AdrienWaeles/french-robotics-cup-2024/Loïc's Reports/Session 12.md

# March 12, 2024
## Main robot
Two session ago, I modeled and printed the system which will hold the plants against the robot's frame. when I tried to mount them on the robot, I realized that the system was a little bit too long. I had to cut it and reassemble it. The difficulty was to cut the guide rail because it is made out of hardened steel so it cannot be cutted with a regular steel saw. Finally I found out that a [Dremel®]('https://www.dremel.com/fr/fr/p/dremel-8260-f0138260ja') with the right blade was able to cut through it whithout too much difficulties.

<div align="center">
    

    Cutted rail guide
</div>

## Ladybug robot
### Components
Last session, I chose the components for the ladybug robot. Before starting to model the ladybug itself, I modeled on SolidWorks the components that will be used in the robot. I modeled the DC motor, the servo motors and the DWM1001 module. I found the other components on the internet because they are standard. Here are the components I modeled myself on SolidWorks:

<div align="center">
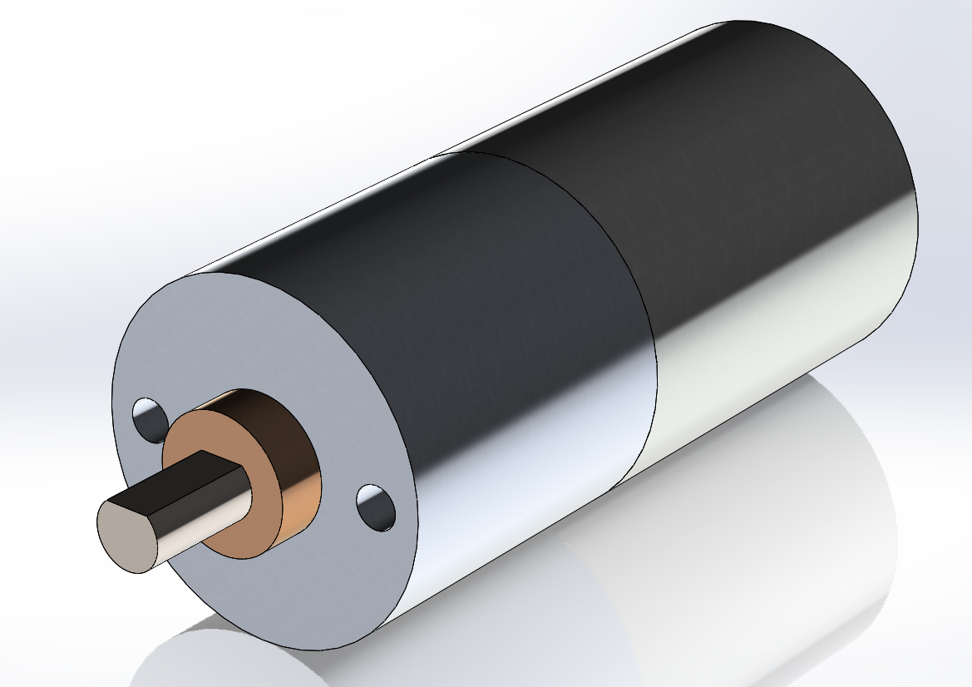
[picture p21: Loïc's Reports/src/session_12/moteur dc.png]
DC motor
    

    DC motor
</div>
<div align="center">
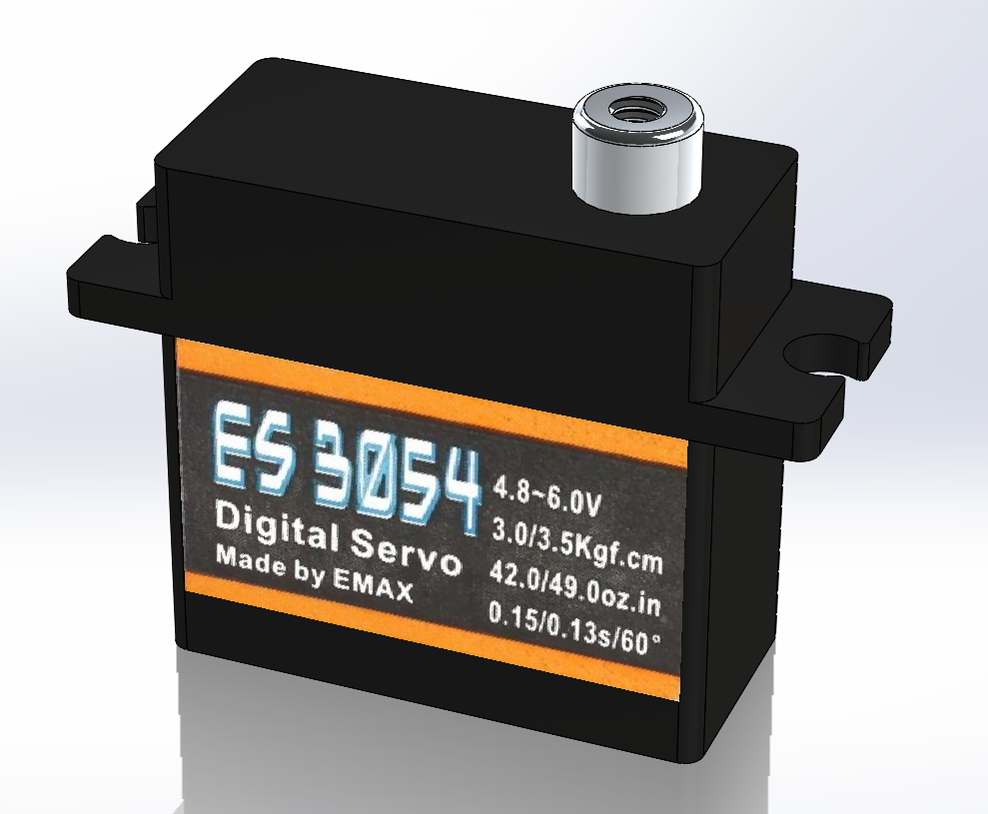
[picture p22: Loïc's Reports/src/session_12/servo 1.png]
Servo motor
    

    Servo motor (for the direction)
</div>
<div align="center">
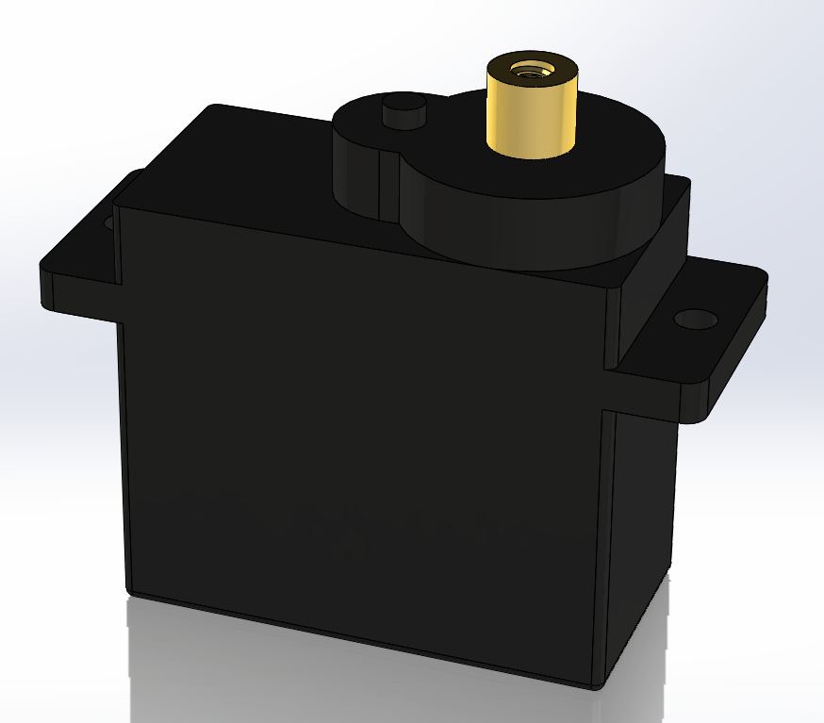
[picture p23: Loïc's Reports/src/session_12/servo 2.png]
Servo motor
    

    Servo motor (for the actuator), a bit smaller than the previous one
</div>
<div align="center">
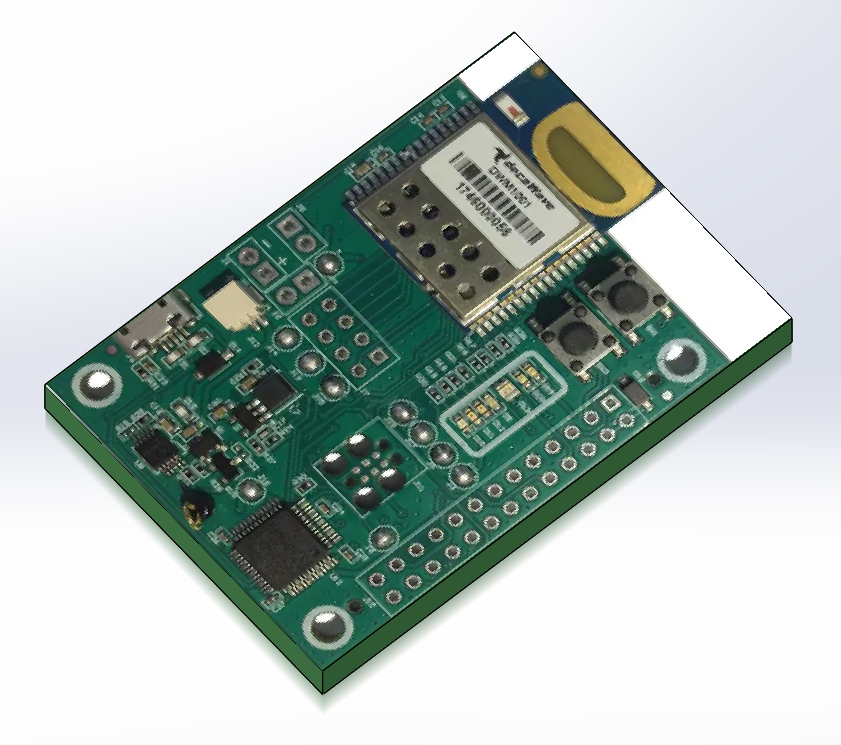
[picture p24: Loïc's Reports/src/session_12/DWM1001.png]
    

    DWM1001 module
</div>

Here are the components I found on the internet ([GrabCAD]('https://grabcad.com/library')):
<div align="center">
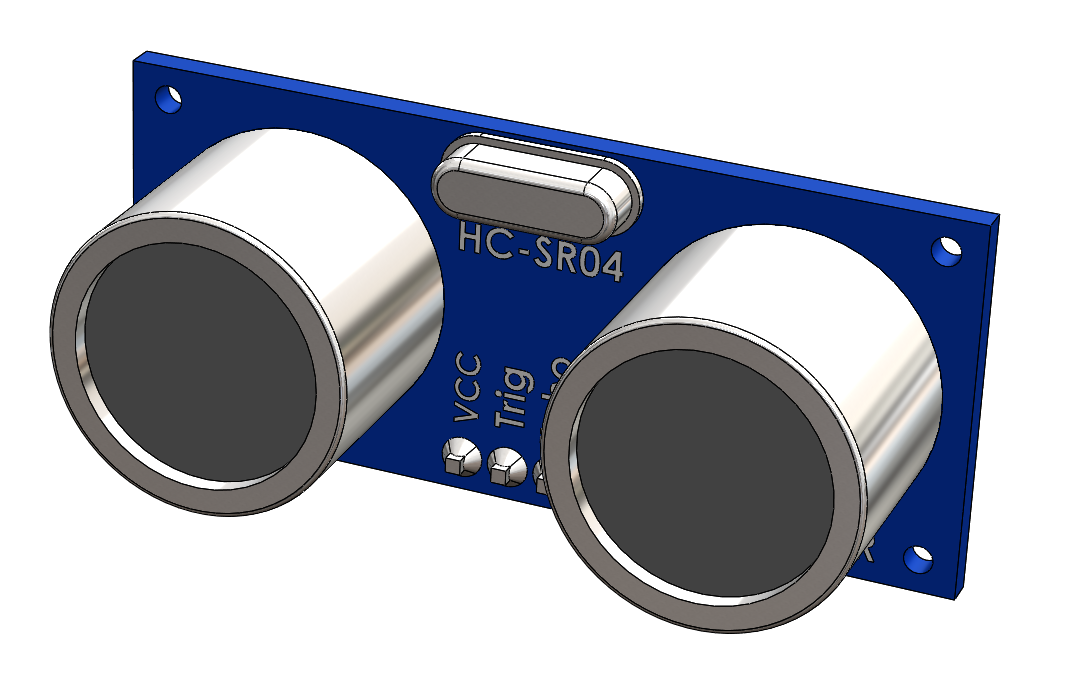
[picture p25: Loïc's Reports/src/session_12/ultrasonic.png]
    

    Ultrasonic sensor
</div>
<div align="center">
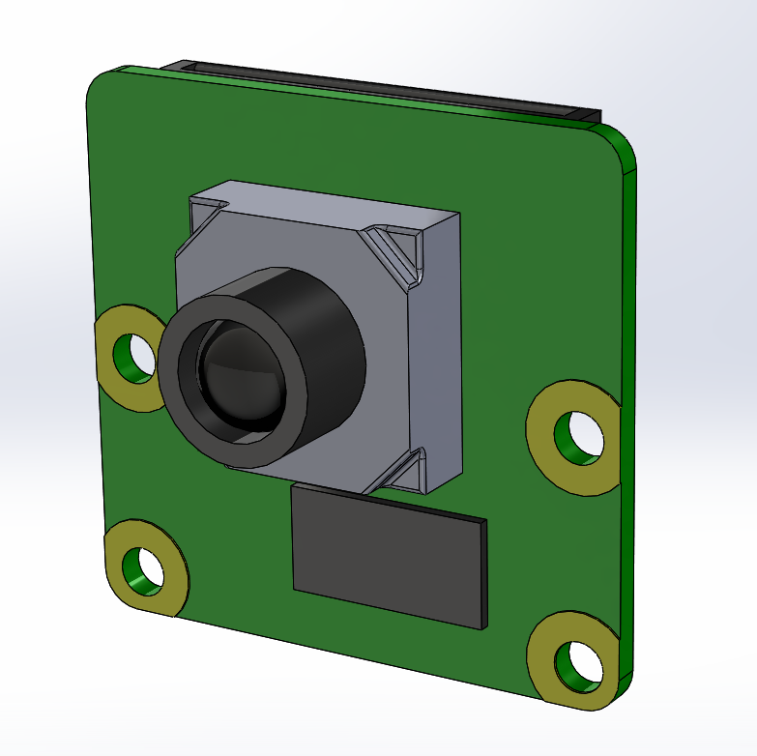
[picture p26: Loïc's Reports/src/session_12/camera.png]
    

    Raspberry Pi camera
</div>
<div align="center">
    Servo motor

    18650 battery in a holder
</div>
<div align="center">
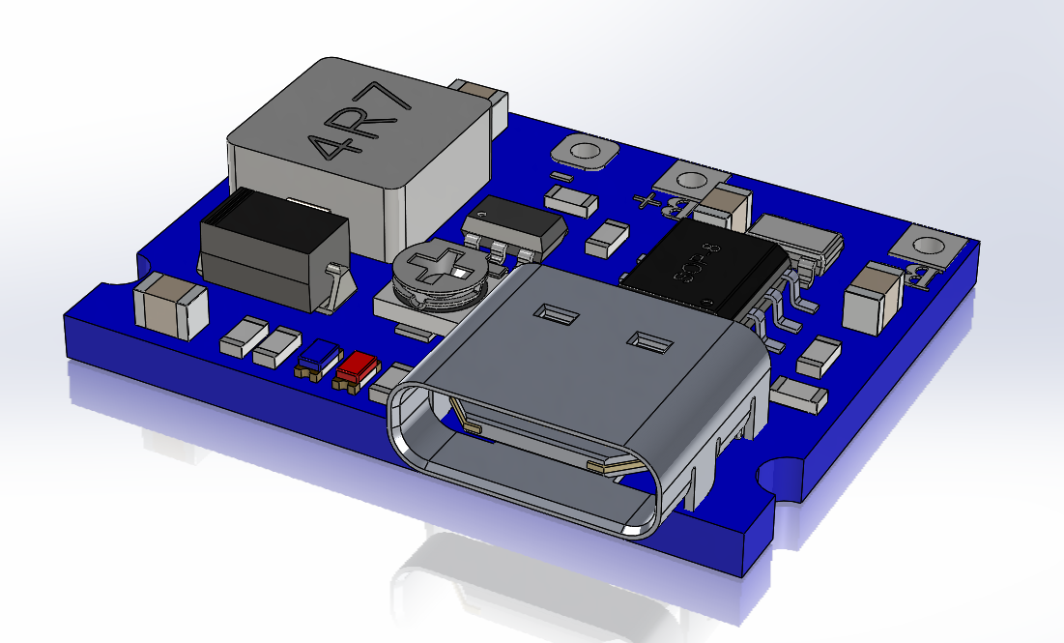
[picture p27: Loïc's Reports/src/session_12/bms.png]
    

    BMS (Battery Management System) for the 18650 battery and step-up module (3.7V to 5V)
</div>
<div align="center">
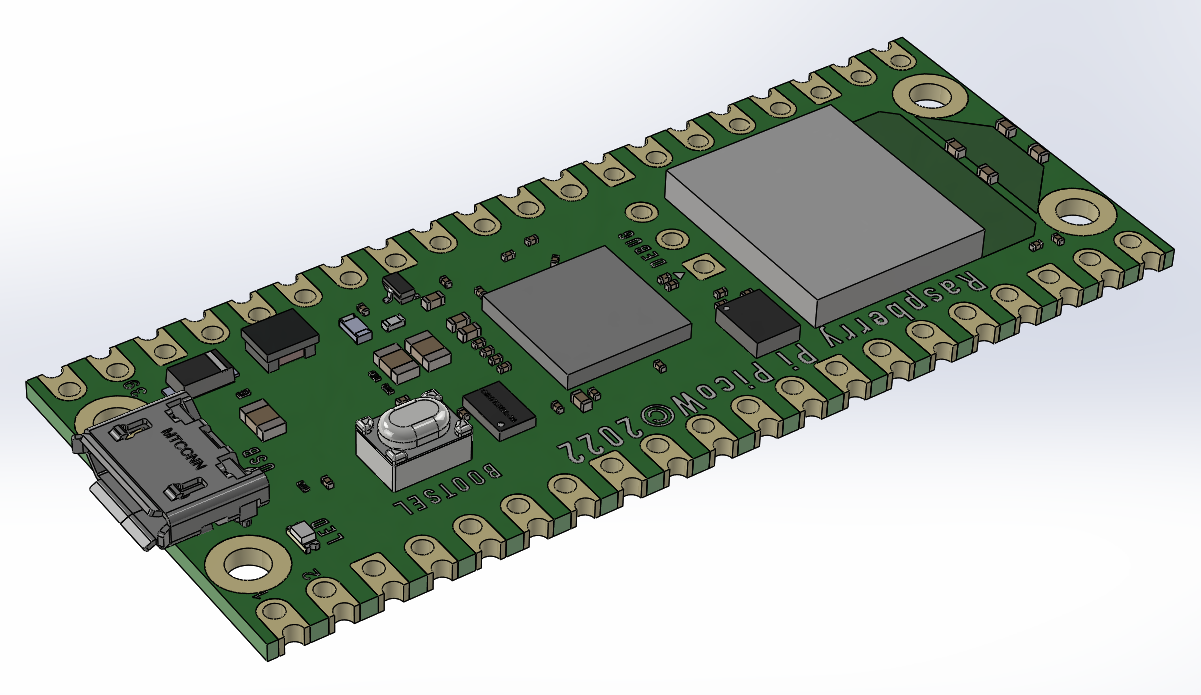
[picture p28: Loïc's Reports/src/session_12/raspberry.png]
    

    Raspberry Pi Zero W
</div>
<div align="center">
    Servo motor

    Emergency stop switch
</div>

### Chassis
For the chassis, I modeled it as compact and simple as possible. I designed it so that the DC motor is inside the chassis, so that its mass serves to stabilize the ladybug. The structure of the chassis is very rigid because of its geometry, when can see some holes on the top which are made to screw the other parts on it. Here is the design I came up with:

<div align="center">
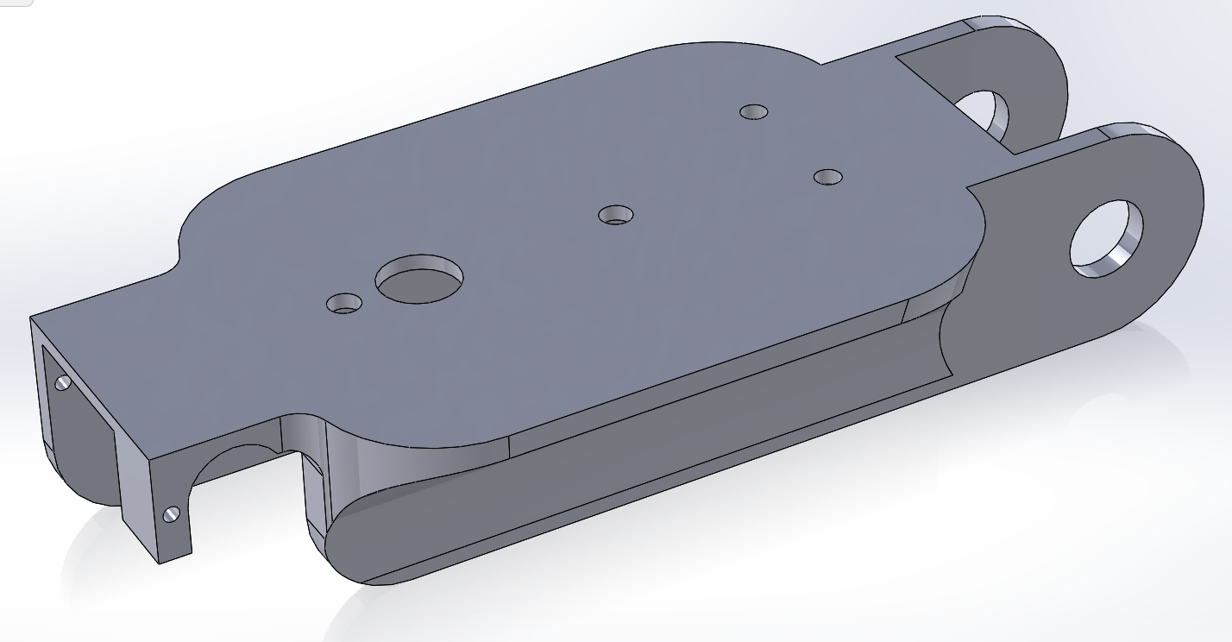
[picture p29: Loïc's Reports/src/session_12/chassis.png]
Chassis
    

    Chassis (Top view)
</div>
<div align="center">
    Chassis

    Chassis (Bottom view)
</div>
<div align="center">
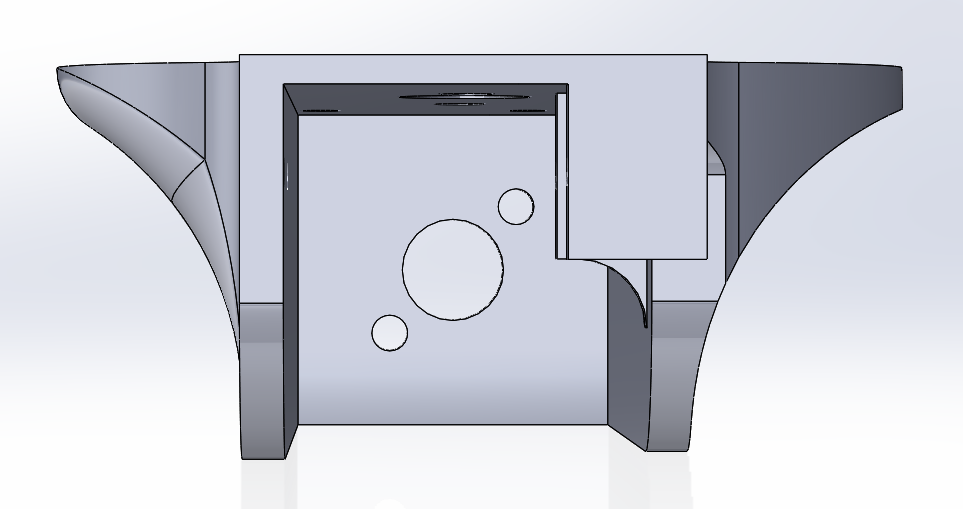
[picture p30: Loïc's Reports/src/session_12/chassis3.png]
Chassis
    

    Chassis (front view)
</div>

Then I added to the chassis the DC motor, the servo motor for the direction and the wheels. A small wheel is mounted on a fork which is attached to the servo motor. In order to transmit the rotational power from the DC motor to the wheels, I designed a small gear system. The gear ratio is 1:1, so the wheels will rotate at the same speed as the DC motor which is already designed at the right speed. The wheels might be a little bit too much apart but I will see this detail later. Here is the chassis with the motors and the wheels:

<div align="center">
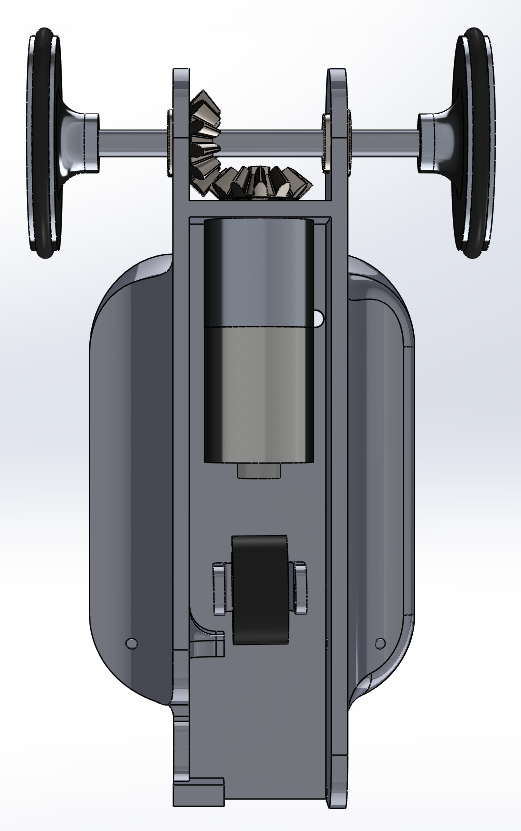
[picture p31: Loïc's Reports/src/session_12/chassis4.png]
Chassis
    

    Chassis with the DC motor, the servo motor and the wheels (Bottom view)
</div>
<div align="center">
    Chassis

    Chassis with the DC motor, the servo motor and the wheels (Top view)
</div>

## Next session
- Continue the ladybug robot
- Adjust some parts of the main robot
