AdrienWaeles/french-robotics-cup-2024/docs/lab-reports/loic/assets/session-11/20240305_111251.jpg

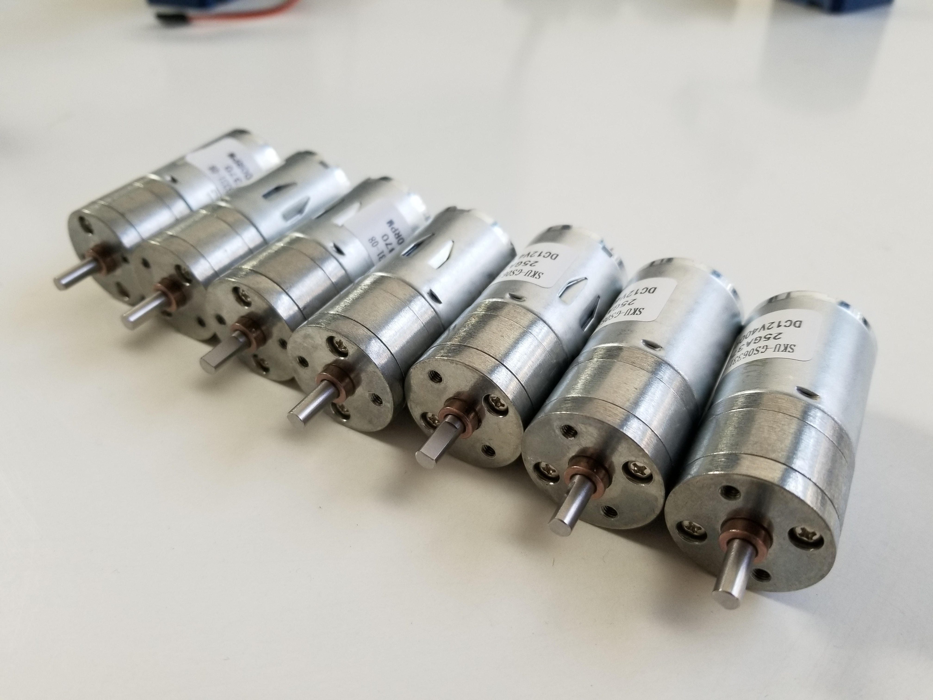
docs/lab-reports/loic/assets/session-11/20240305_111251.jpg
