AdrienWaeles/french-robotics-cup-2024/docs/lab-reports/loic/assets/session-11/emergency switch.png

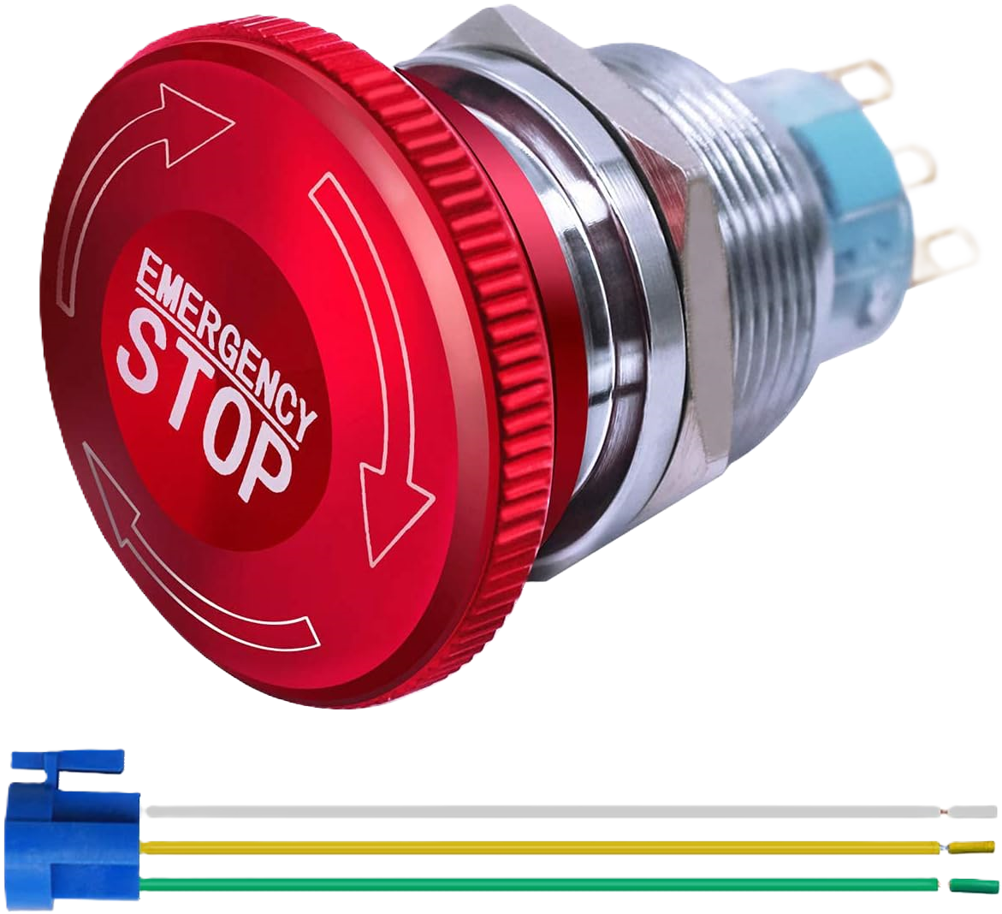
docs/lab-reports/loic/assets/session-11/emergency switch.png
