AdrienWaeles/french-robotics-cup-2024/docs/lab-reports/loic/assets/session-12/chassis2.png

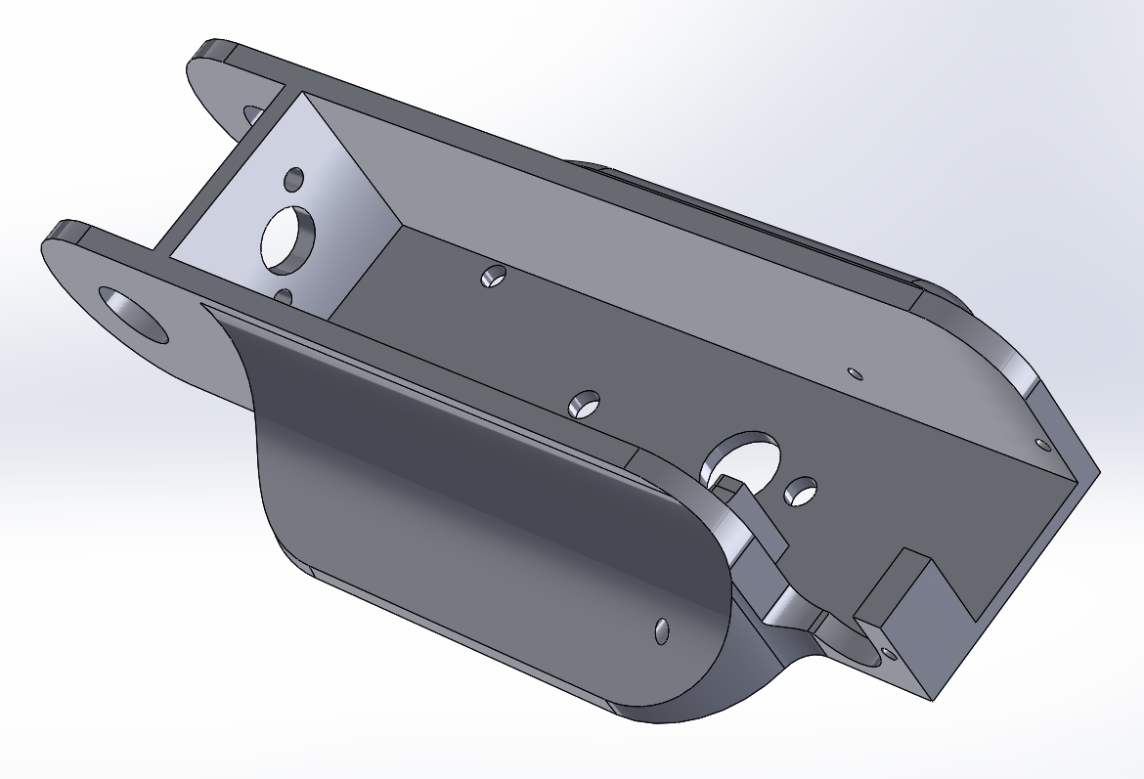
docs/lab-reports/loic/assets/session-12/chassis2.png
