AdrienWaeles/french-robotics-cup-2024/docs/lab-reports/loic/assets/session-13/T shape.png

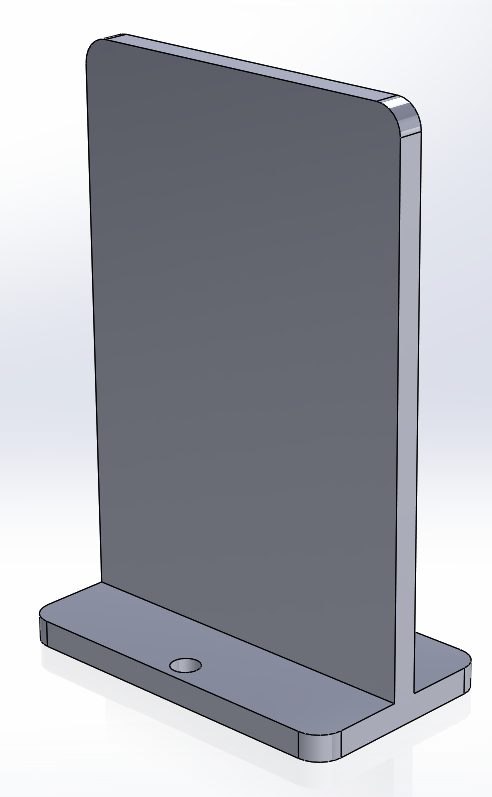
docs/lab-reports/loic/assets/session-13/T shape.png
