AdrienWaeles/french-robotics-cup-2024/docs/lab-reports/loic/assets/session-16/cameras mount.png

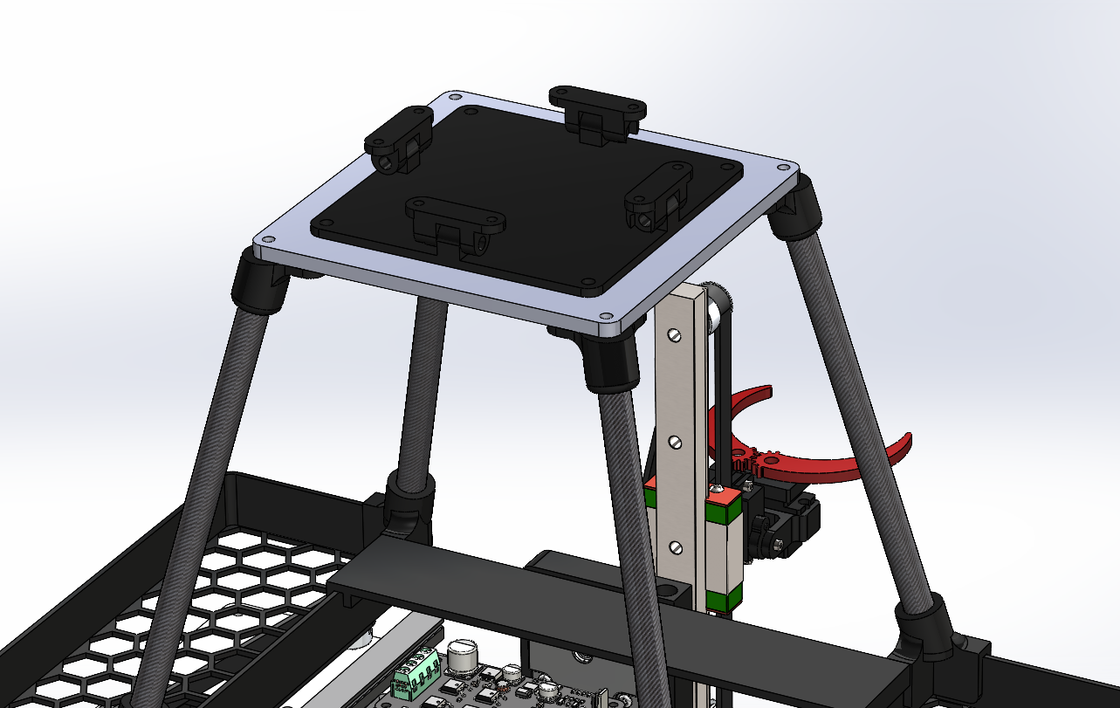
docs/lab-reports/loic/assets/session-16/cameras mount.png
