AdrienWaeles/french-robotics-cup-2024/Loïc's Reports/src/session_12/20240316_220356.jpg

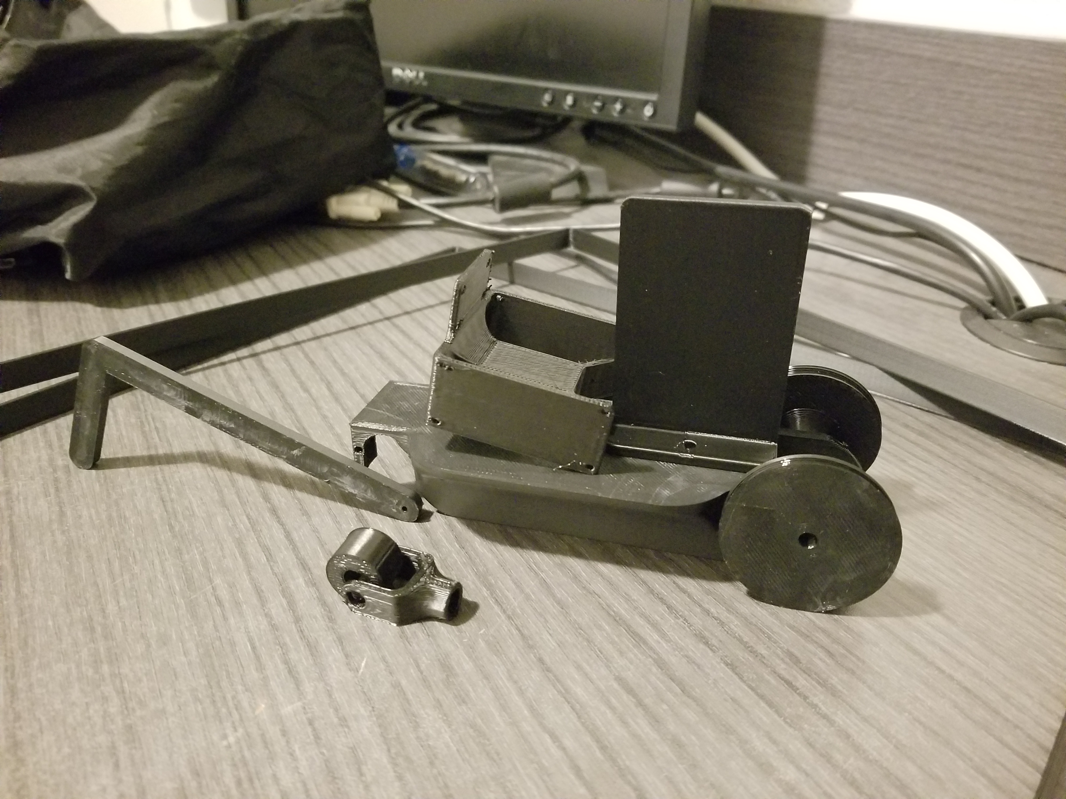
Loïc's Reports/src/session_12/20240316_220356.jpg
