AdrienWaeles/french-robotics-cup-2024/polymartien light.png

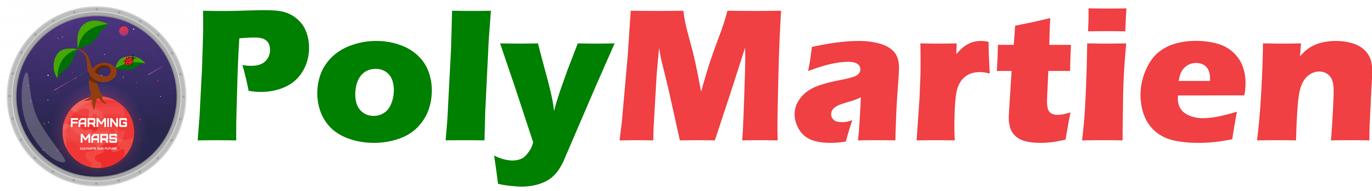
polymartien light.png
