AdrienWaeles/french-robotics-cup-2024/src/plante + pot.png

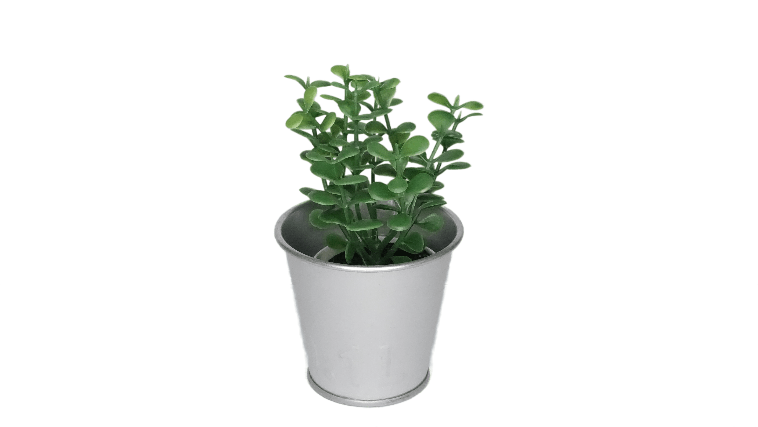
src/plante + pot.png
