AdrienWaeles/french-robotics-cup-2024/hardware/bill-of-materials.md

# Preliminary bill of materials

Cost estimate from the design phase (see the [preliminary design report](../docs/preliminary-design-report.pdf)).
The final budget, €6,191 including the cameras, the swarm robots and travel, is detailed in the
[project retrospective](../docs/project-retrospective.pdf).

| Item | Qty | Cost (€) |
|---|---:|---:|
| Plywood sheet, 5 mm, 300 × 600 mm | 1 | 5 |
| 3D printing (7 h 30, 90 g) |  | 2.7 |
| 3D printing (1 h 30, 20 g) |  | 0.6 |
| Brushless motors | 2 | 62 |
| Emergency stop button | 1 | 8.5 |
| Roller wheels | 2 pairs | 24 |
| Linear guide, 300 × 600 mm | 1 | 32 |
| Belts, 5 m × 6 mm × 2 mm | 3 | 25 |
| DC motors, 24 V, 35 W, 220 rpm | 2 | 234 |
| NEMA 17 stepper motor | 1 | 13 |
| GT2 pulleys | 2 | 2.7 |
| Stepper driver (Arduino) | 1 | 2.2 |
| Cytron DC motor drivers, 5–30 V, 10 A | 2 | 26 |
| Arduino Mega | 1 | 23 |
| NVIDIA Jetson Nano | 1 | 250 |
| V-slot aluminium profiles, 250 × 20 × 20 mm | 4 | 55 |
| Assorted screws |  | 20 |
| Game mat and printed game elements |  | 170 |
| Construction wood |  | 135 |
| Wood delivery |  | 60 |
| **Total** | | **1150.7** |
