AdrienWaeles/french-robotics-cup-2024/Fabrication/coin.STL

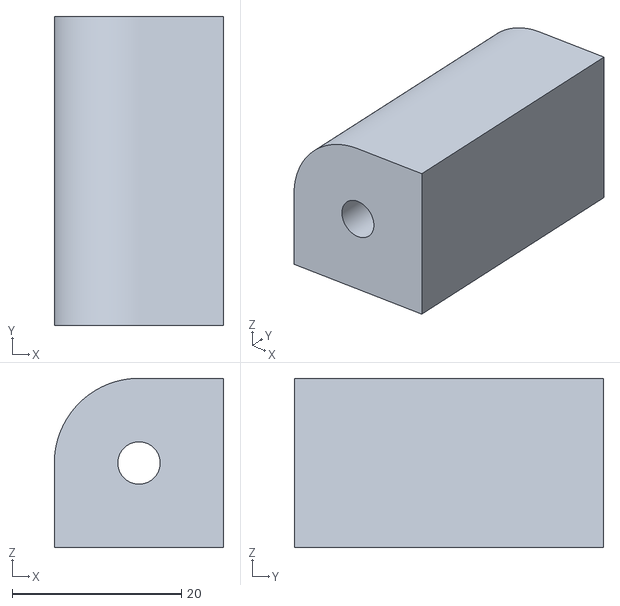
[picture p53: CAD file, 2023-10-07]
Fabrication/coin.STL
20.0 x 36.5 x 20.0
