AdrienWaeles/french-robotics-cup-2024/Fabrication/Impressions 3D/support nema plateau.STL

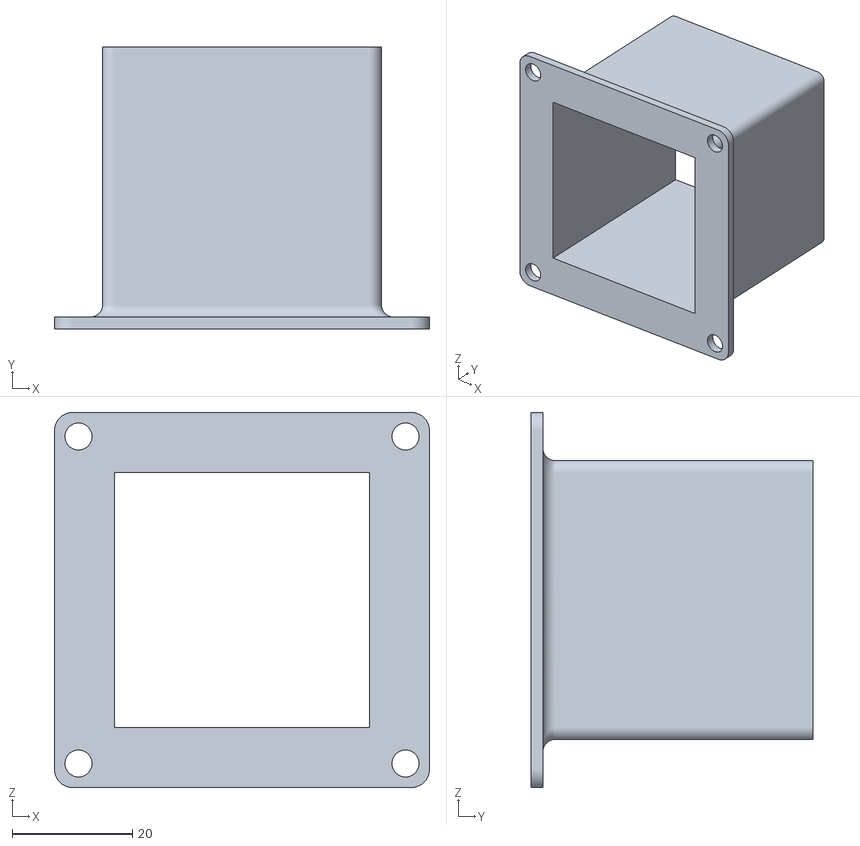
[picture p54: CAD file, 2023-10-07]
Fabrication/Impressions 3D/support nema plateau.STL
62.5 x 47.0 x 62.5
