AdrienWaeles/french-robotics-cup-2024/Loïc's Reports/src/session_03/support pivot.stl

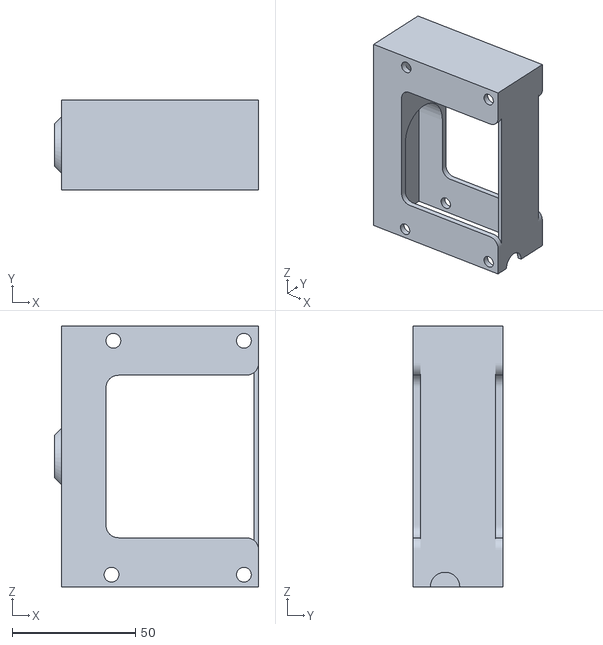
[picture p55: CAD file, 2023-12-09]
Loïc's Reports/src/session_03/support pivot.stl
83.0 x 36.5 x 106.0
