AdrienWaeles/french-robotics-cup-2024/Fabrication/support roulement.STL

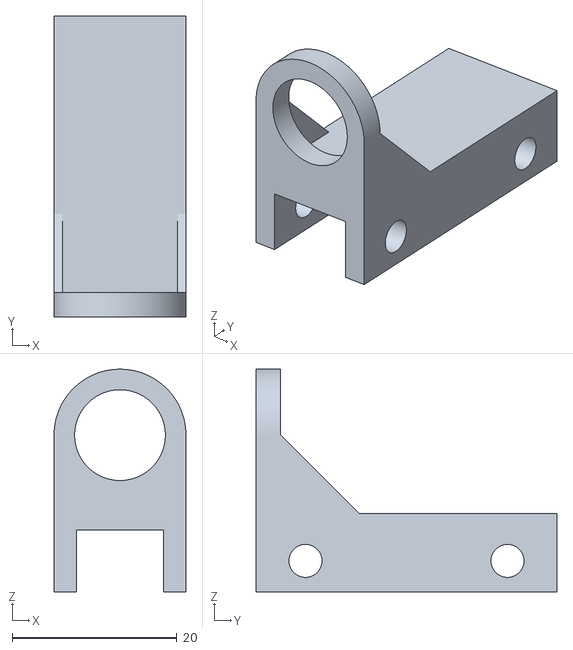
[picture p56: CAD file, 2023-10-07]
Fabrication/support roulement.STL
16.0 x 36.5 x 27.0
