AdrienWaeles/french-robotics-cup-2024/Fabrication/support moteur.STL

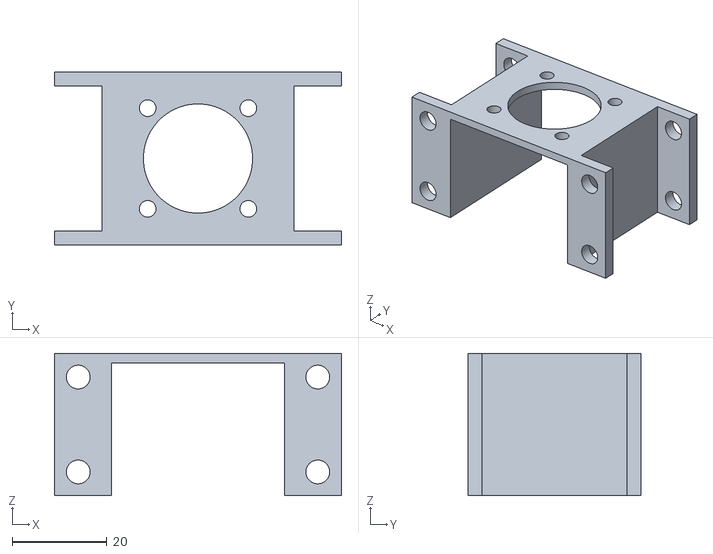
[picture p57: CAD file, 2023-10-07]
Fabrication/support moteur.STL
60.5 x 36.5 x 30.0
