AdrienWaeles/french-robotics-cup-2024/Fabrication/commande profilé alu.jpg

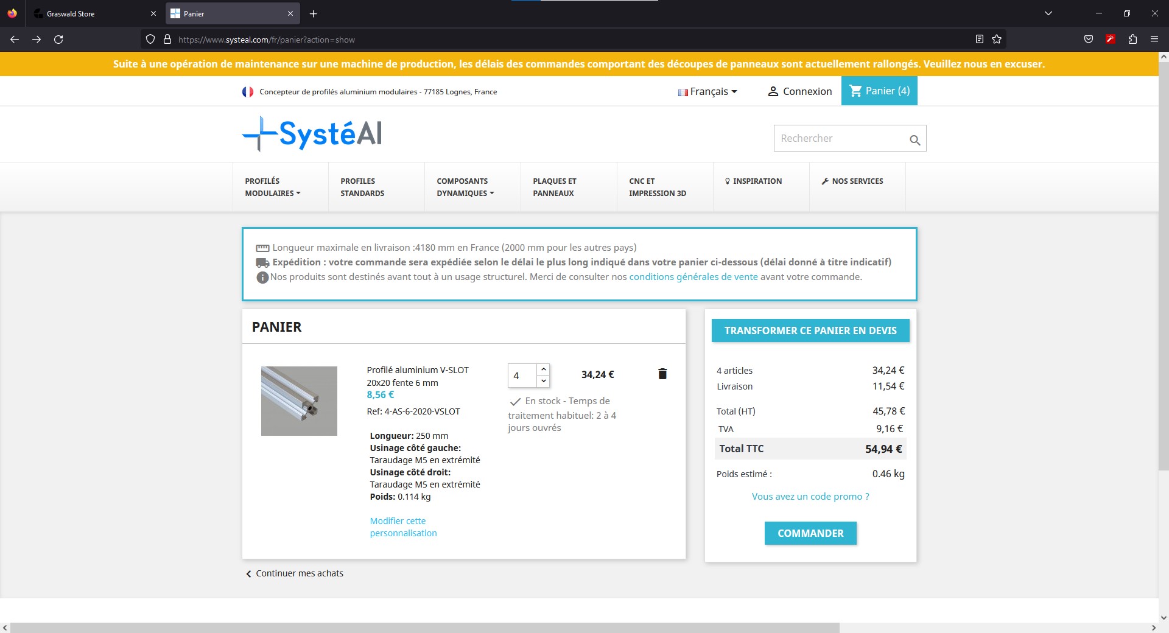
Fabrication/commande profilé alu.jpg
