AdrienWaeles/french-robotics-cup-2024/hardware/electrical/wiring-diagram.pdf

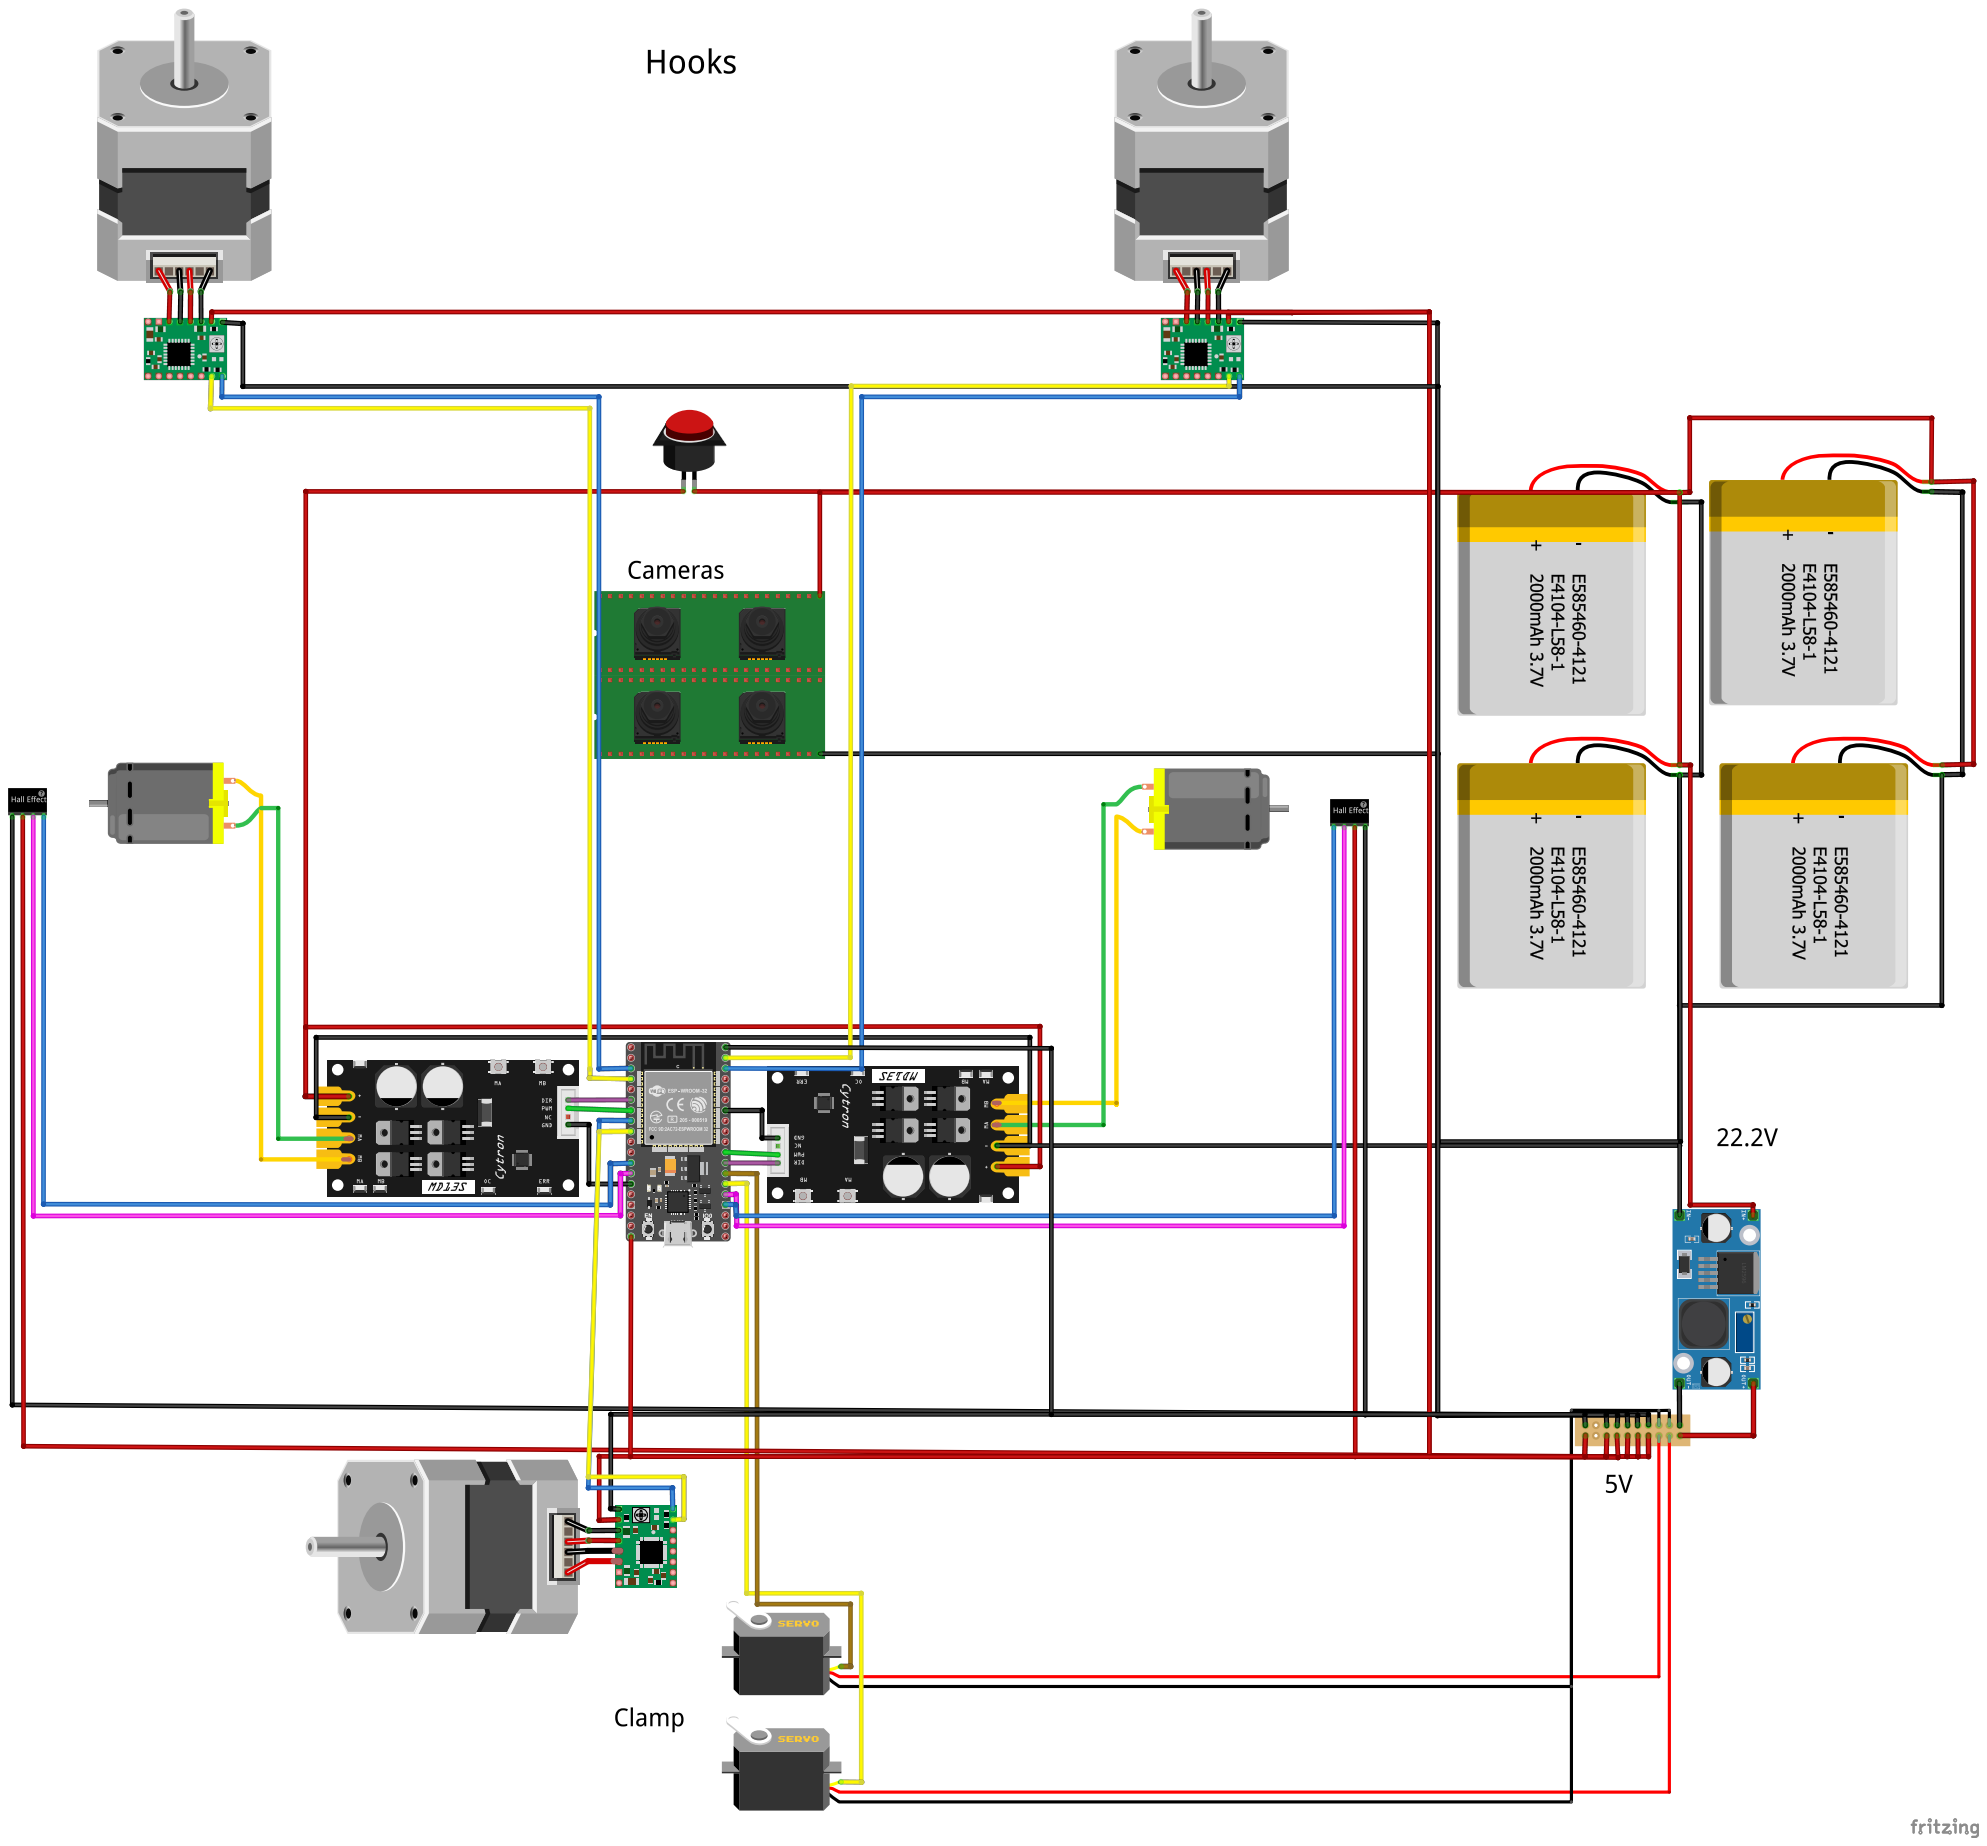
[picture p59: page 1]
