AdrienWaeles/french-robotics-cup-2024/(commit log)

2023-10-08 Création des dossiers de rapport
2026-10-28 Move Arduino sketches to firmware/
2026-10-28 Fix encoder period read and division by zero in DC motor test
2026-10-28 Arm the ESC at startup in brushless motor test
2026-10-28 Fix encoder period read and bound the command in Bluetooth motor test
2026-10-28 Translate the bill of materials to English
