AdrienWaeles/french-robotics-cup-2024/Loïc's Reports/src/session_17/3.jpg

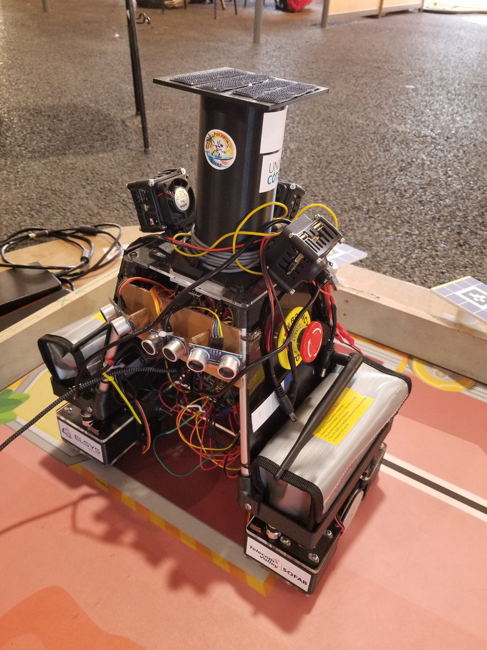
[picture p3: Loïc's Reports/src/session_17/3.jpg]
Loïc's Reports/src/session_17/3.jpg
