AdrienWaeles/french-robotics-cup-2024/Loïc's Reports/src/session_15/20240502_090020.jpg

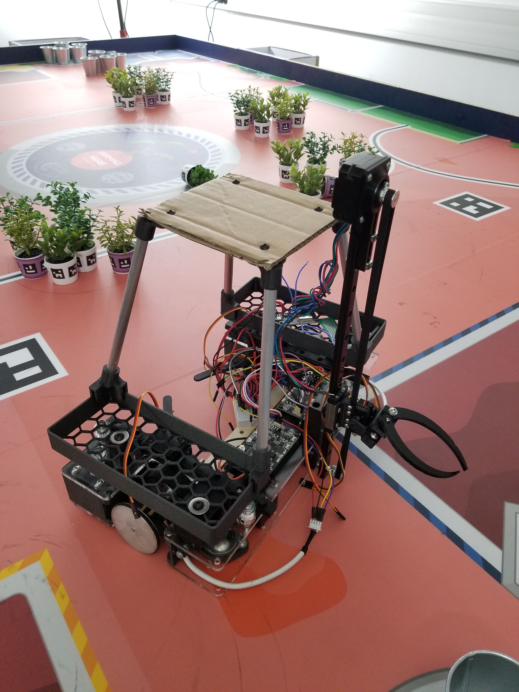
[picture p6: Loïc's Reports/src/session_15/20240502_090020.jpg]
Loïc's Reports/src/session_15/20240502_090020.jpg
