AdrienWaeles/french-robotics-cup-2024/Loïc's Reports/src/session_15/1 (2).jpg

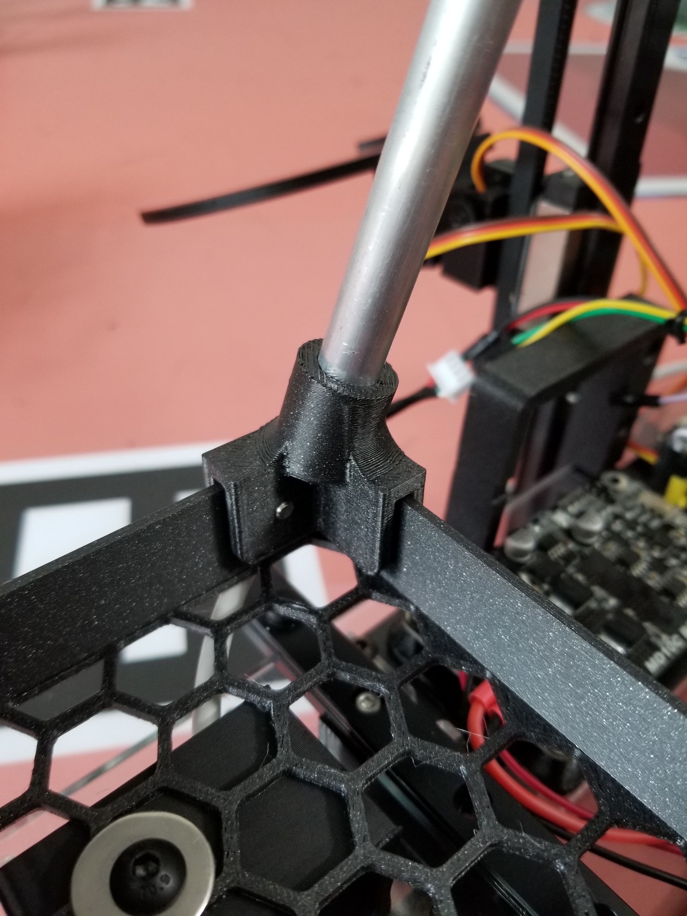
[picture p7: Loïc's Reports/src/session_15/1 (2).jpg]
Loïc's Reports/src/session_15/1 (2).jpg
