AdrienWaeles/french-robotics-cup-2024/Loïc's Reports/src/session_15/1 (3).jpg

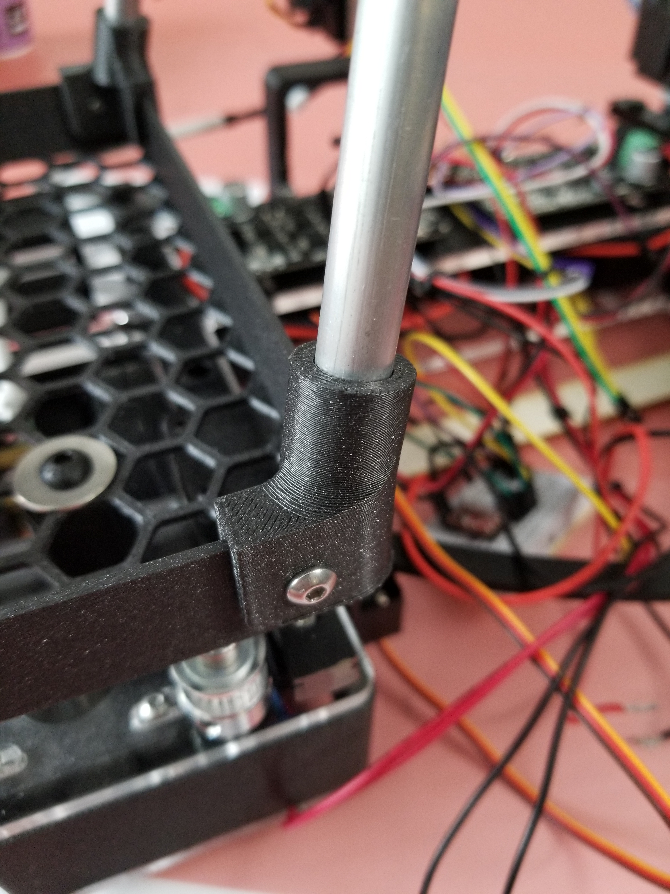
[picture p8: Loïc's Reports/src/session_15/1 (3).jpg]
Loïc's Reports/src/session_15/1 (3).jpg
