AdrienWaeles/french-robotics-cup-2024/Loïc's Reports/src/session_15/20240502_090000.jpg

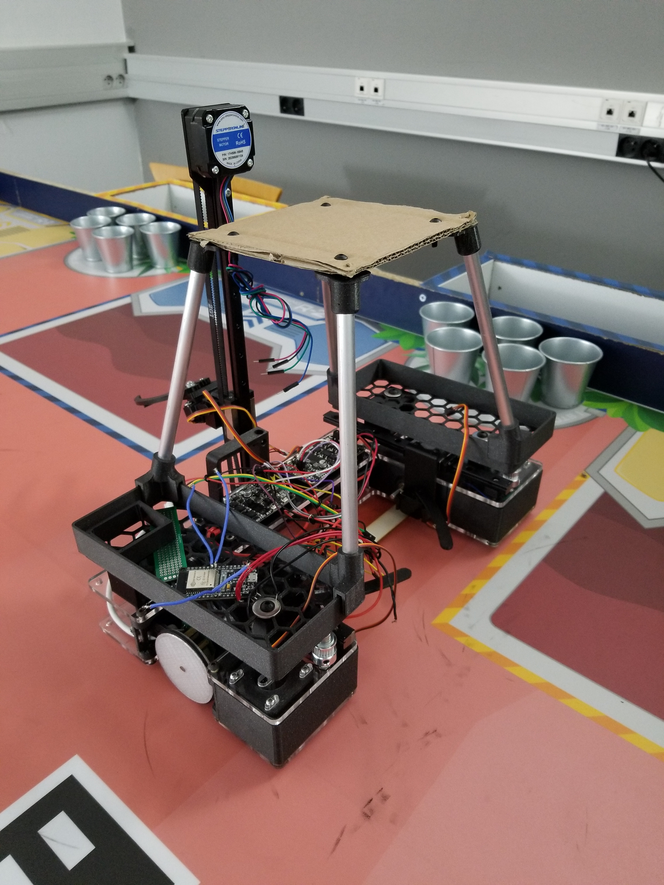
Loïc's Reports/src/session_15/20240502_090000.jpg
